martin-ger/ESP_E58-Drone/(threads)

Thread 2 (2022-12-31):

UPD to Serial ESP32

omalave, 2022-12-31:
Do you know a way to write to serial (yellow wire in the wifi -> flight controller) using esp32? I can sniff the traffic using UART but I cannot write. It's same protocol as UDP?

martin-ger, 2023-01-02:
I think so.
